furbrain/STIC/README.md

Shetland Attack Pony 6
======================

The Shetland Attack Pony 6 is a cave surveying tool. It is completely open source, all the code and hardware designs are available within this repository

Devices can be purchased from [my webshop](https://www.shetlandattackpony.co.uk)

Documentation is available at  [readthedocs](https://stic.readthedocs.io/en/latest/)
