furbrain/STIC/docs/Example of EU declaration of conformity (DoC) adopted by EMC ADCO.docx

EU Declaration of Conformity (DoC)

We

Company name: | Underwood Underground
Postal address: | 47 Robin Lane, High Bentham
Postcode: | LA2 7AG
City: | Lancaster
Telephone number: | +44 773 928 5952
E-Mail address:

declare that the DoC is issued under our sole responsibility and belongs to the following product:

Apparatus model/Product: | SAP6
Type:
Batch: | -
Serial number:

Object of the declaration (identification of apparatus allowing traceability; it may include a colour image of sufficient clarity where necessary for the identification of the apparatus):

See attached image. Colouration may vary

The object of the declaration described above is in conformity with the relevant Union harmonisation legislation:

EMC Directive 2014/30/EU

Directive 2011/65/EU — RoHS Directive, including (EU) 2015/863
Directive 2014/53/EU – Radio Equipment Directive | | | | ...

The following harmonised standards and technical specifications have been applied:

Title, Date of standard/specification:

IEC 62321-3-1: 2013 | | IEC 62321-5: 2013
Notified body (where applicable): | | 4 digit notified body number:
N/A

Additional information:

Signed for and on behalf of:

| | | | P. Underwood, Director
Place of issue | | Date of issue | | Name, function, signature
