furbrain/STIC/docs/RII exemption.odt

DECLARACIÓN DE EXENCIÓN – REGISTRO INTEGRADO INDUSTRIAL (RII)

Yo, Phil Underwood, actuando como fabricante del siguiente producto:

Producto: Shetland Attack Pony
Modelo / Tipo: SAP6

DECLARO QUE:

El fabricante no está establecido en España y no dispone de centro productivo ni establecimiento industrial en territorio español, por lo que no está obligado a inscribirse en el Registro Integrado Industrial (RII) de ninguna Comunidad Autónoma, de conformidad con la normativa aplicable.

Esta declaración se emite exclusivamente a efectos de su presentación ante la Aduana española.

En High Bentham, a 19/1/2026

Firma: P. Underwood
Nombre: Phil Underwood
Dirección: 47 Robin Lane, High Bentham, North Yorkshire, LA2 7AG
País: United Kingdom
