furbrain/STIC/docs/pony_art.png

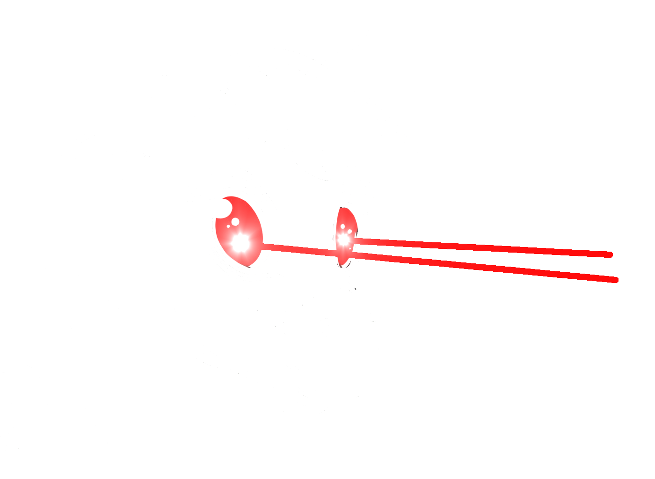
docs/pony_art.png
