furbrain/STIC/docs/SAP6b-228x228.jpg

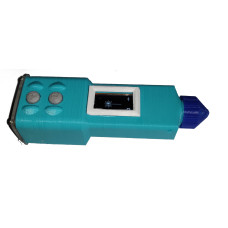
docs/SAP6b-228x228.jpg
