furbrain/STIC/docs/tshirt_front.png

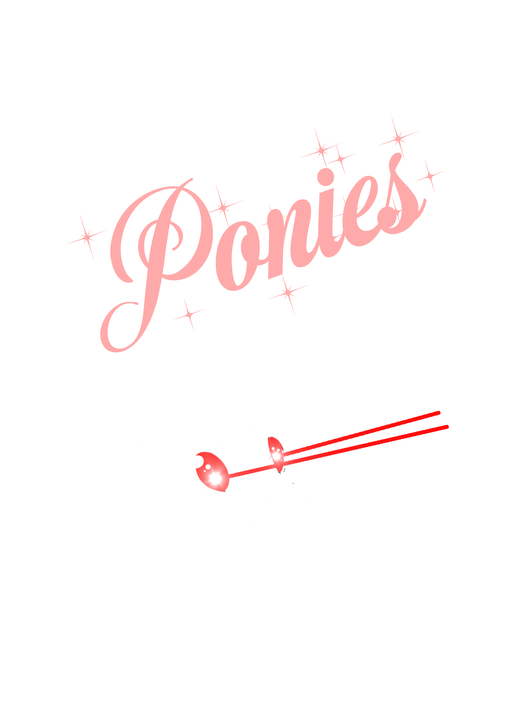
docs/tshirt_front.png
