furbrain/STIC/case/bigboy-mount.stl

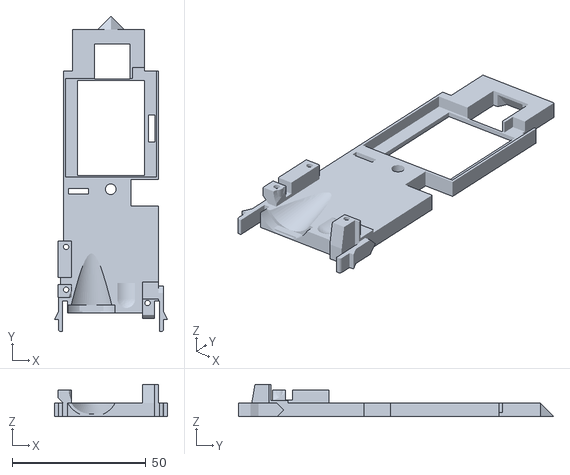
[picture p5: CAD file, 2025-06-13]
case/bigboy-mount.stl
42.3 x 118.0 x 12.0
