furbrain/STIC/hardware/Button/Button.step

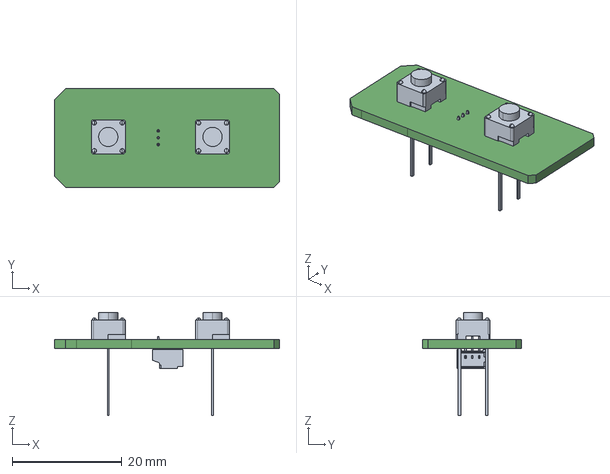
[picture p6: CAD file, 2023-05-13]
hardware/Button/Button.step
41.0 x 18.0 x 18.8 mm
