furbrain/STIC/hardware/PCB/STIC.step

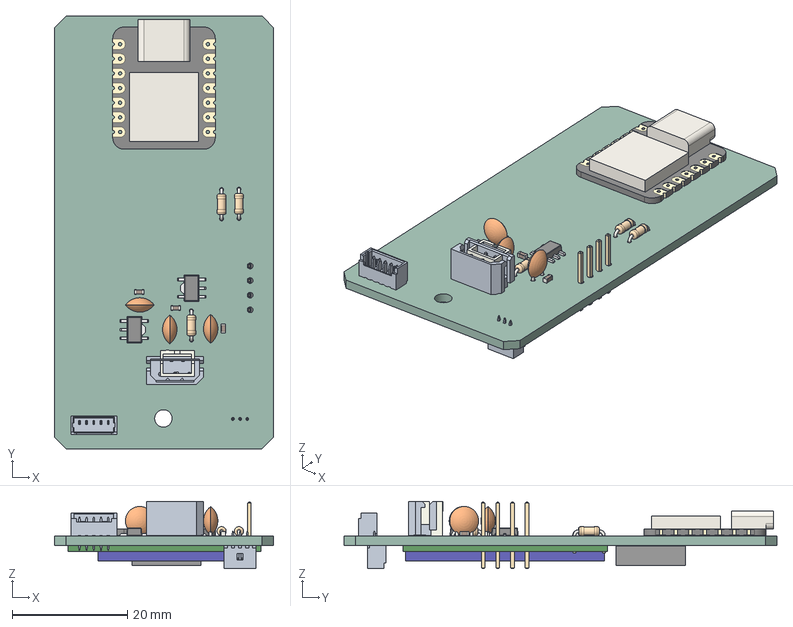
[picture p7: CAD file, 2024-05-04]
hardware/PCB/STIC.step
38.0 x 75.1 x 11.7 mm
Seeeduino Xiao v2
AP7361C-33Y5-13 x 2
C_Disc_D50mm_W25mm_P250mm x 3
R_Axial_DIN0204_L36mm_D16mm_P508mm_Horizontal x 3
JST_B2B_PH_K
C_0603_1608Metric x 3
R_0603_1608Metric x 3
ASSEMBLY
STIC_PCB
