furbrain/STIC/case/button_pcb_jig.stl

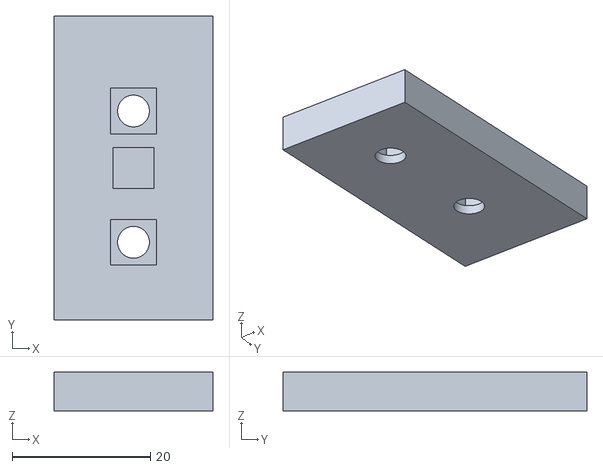
[picture p8: CAD file, 2024-11-16]
case/button_pcb_jig.stl
23.0 x 44.0 x 5.60
