furbrain/STIC/case/bigboy-Shim.stl

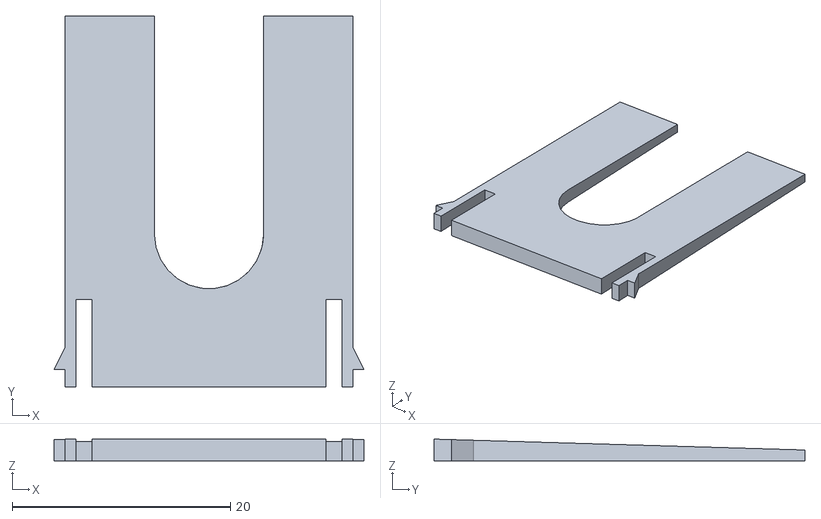
[picture p9: CAD file, 2023-12-16]
case/bigboy-Shim.stl
28.4 x 34.0 x 2.00
