furbrain/STIC/case/Acrylic.dxf

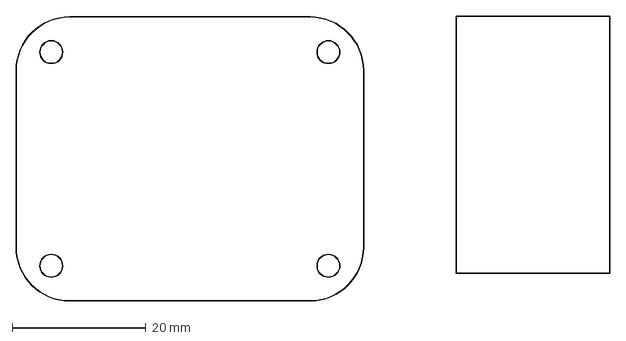
[picture p10: CAD file, 2023-12-16]
case/Acrylic.dxf
88.9 x 42.6 mm
