furbrain/STIC/case/button_mould.FCStd

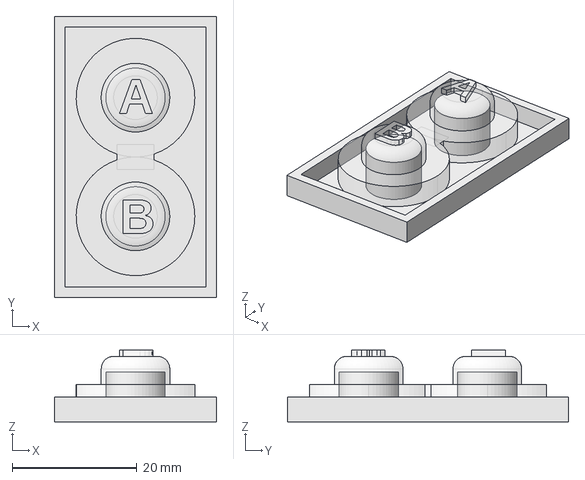
[picture p11: CAD file, 2023-08-31]
case/button_mould.FCStd
26.0 x 45.0 x 11.5 mm
TopPlain
Boot
