furbrain/STIC/case/bigboy-Shell.stl

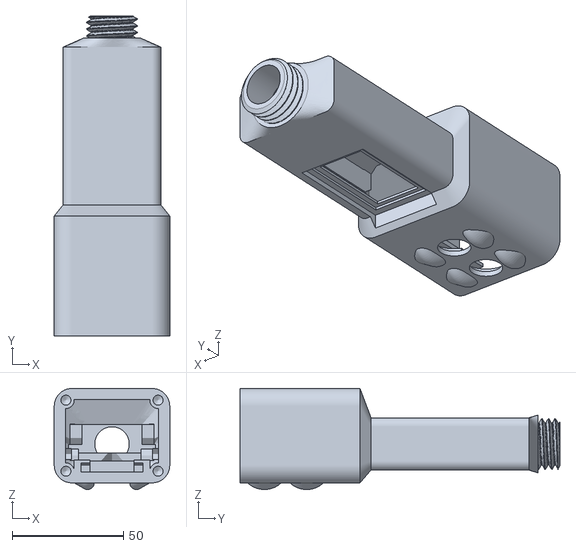
[picture p12: CAD file, 2023-06-18]
case/bigboy-Shell.stl
52.0 x 144.0 x 45.5
