furbrain/STIC/case/EVA Foam.dxf

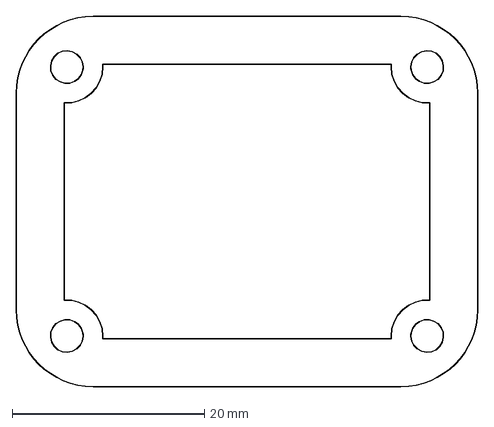
[picture p13: CAD file, 2023-03-01]
case/EVA Foam.dxf
48.0 x 38.5 mm
