furbrain/STIC/case/bigboy.FCStd

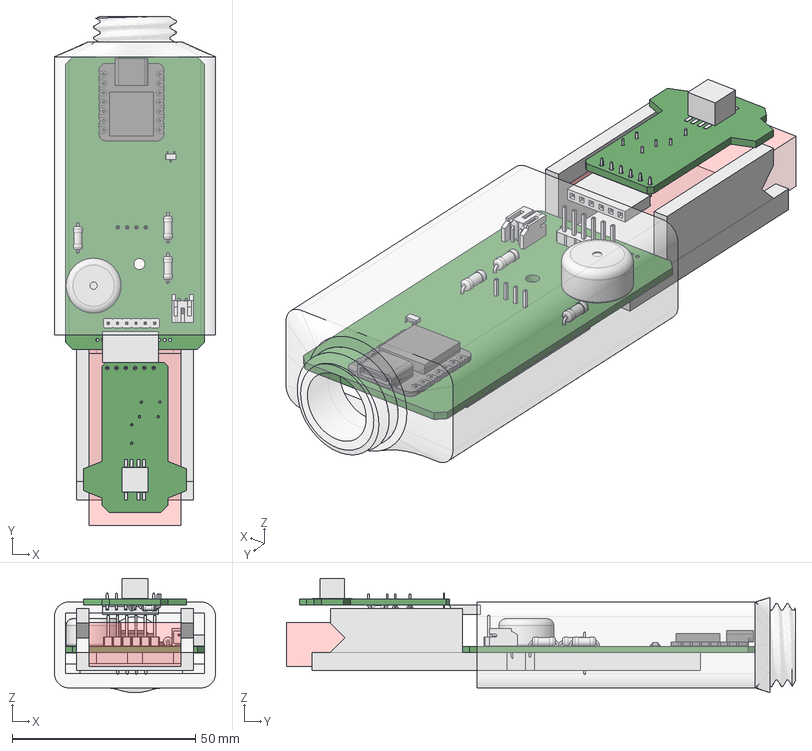
[picture p14: CAD file, 2023-01-22]
case/bigboy.FCStd
44.0 x 139.0 x 31.2 mm
Laser
mount
back
