furbrain/STIC/case/display_mount.FCStd

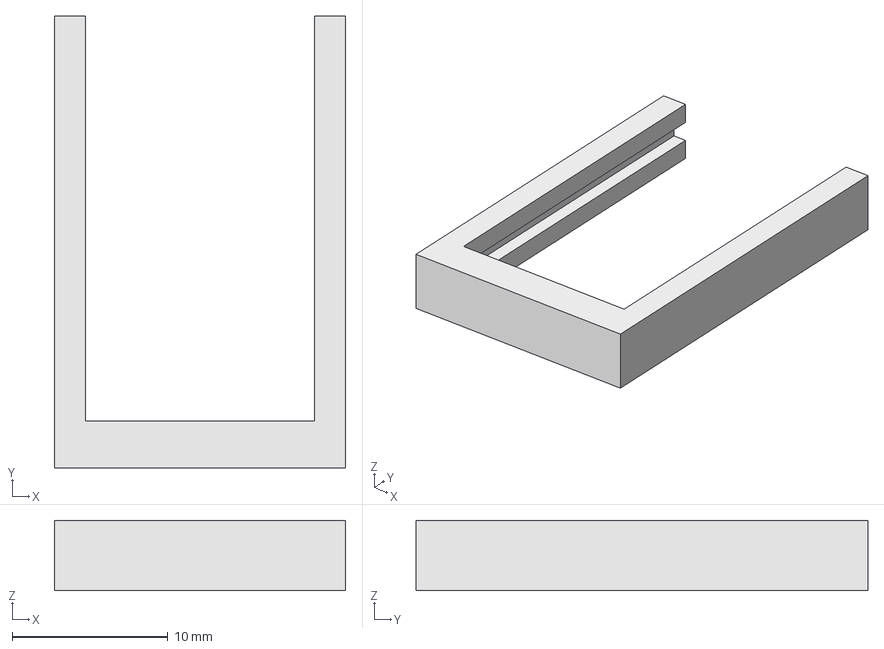
[picture p15: CAD file, 2023-01-22]
case/display_mount.FCStd
18.7 x 29.0 x 4.50 mm
