furbrain/STIC/(list of files, cad)

Other CAD files:
case/STIC.step
case/Button.step
case/display_mount.stl
