furbrain/STIC/(threads)

Thread 1 (2024-01-03):

certain laser read errors report as TimeoutError

echarlie, 2024-01-03:
sometimes when shooting at a reflective surface or at an odd angle surface, the screen displays `asyncio/funcs.py:75:wait_for TimeoutError:" rather than a Laser Read Error.

furbrain, 2024-01-04:
Looks like the code that picks up on the last errors doesn't account for this. I'll need to fix this

furbrain, 2024-01-06:
@echarlie  I'll make the timeout error give a nicer response.
Currently the timeout for the laser is set to 3s, would you prefer to wait longer and get a reading or get an error quicker?

Closed 2024-01-07.

Thread 7 (2024-01-08):

Document hard reset button

furbrain, 2024-01-08:
- [x] photo of end with arrow pointing at location
- [x] photo of bare board (again with arrow)
- [x] description on index.rst

furbrain, 2024-04-20:
Done

Closed 2024-04-20.

Thread 8 (2024-01-08):

Document production process

furbrain, 2024-01-08:
- [ ] Make BOM
- [ ] link to files on github releases
- [ ] update docs

milewis, 2024-09-03:
Phil,

I'm working on building a SAP from scratch.  I've got the board soldered up and have the device showing as circuitpy on my computer.  I'm a bit lost as to which files I should be moving over to the nrf device.  Any direction would be very helpful.  I'd also love to help with any documentation I can.  Are you needing anything on the build process documented in particular?

furbrain, 2024-09-07:
The first thing is you need a special version of circuitpython installed - you can get it from https://github.com/furbrain/SAP6_board/releases/download/1.0/sap6_cp_9.0.0.uf2
You will need to create a `firmware` directory on the nrf device and put all the python files from `firmware.zip` in there.

You will also need to create and populate the `fonts` and `images` directories, and also copy `safemode.py` `boot.py` and `code.py` from `firmware/installer` into the root directory. The final directory structure should look like:
```
├── boot.py
├── code.py
├── firmware
│   ├── ***lots of python files***
│   └── versions
│       ├── display128x64.py
│       ├── hardware_v1.py
│       └── __init__.py
├── fonts
│   ├── limited
│   ├── terminus_20_ascii.pcf
│   ├── terminus_22_ascii.pcf
│   ├── terminus_24_ascii.pcf
│   └── terminus_28_ascii.pcf
├── images
│   ├── battery.bmp
│   ├── batt_icon.bmp
│   ├── bt.bmp
│   ├── laser.bmp
│   └── laser.xbm
├── manual.pdf
└── safemode.py
```

Thread 13 (2024-01-15):

Device becomes unresponsive several months after first power on

furbrain, 2024-01-15:
1-2 months after power on the device stops responding to the button presses to turn on

furbrain, 2024-01-15:
This is due to circuitpython's `time.monotonic()` returning a float, which only has 22 bits of precision. As it represents time since power first applied to device (which is not reset by a reset!), this will start degrading to 1 second resolution after about 25 days. This means that the turn on code may stop working at this point (possibly 50 days), difficult to test.

Fix is to switch to `supervisor.time_ms()`, which is an int. This can wrap but would need an attempt to switch on at *exactly* the right moment. A second attempt would then be successful

Closed 2024-01-15.

Thread 20 (2024-02-06):

consider power-off with double-click B instead of A

echarlie, 2024-02-06:
On a survey trip with the SAP6 over the weekend, I found we would shut down the SAP on accident fairly often, either by muscle spasm while taking a shot, or it not responding immediately when turning on (so you get a trill of the power on, then the power off sound, before the screen has powered up).

Changing power-off to the B button would ensure this happens accidentally less often.

furbrain, 2024-02-07:
Unfortunately double-click B is now taken as "return to most recent reading", when browsing through previous readings.
There is a lockout to prevent turn-on- turn-off, but it's only 0.5s. I'd be open to a PR to change this to say 2-5 seconds (it's in quitter_task in app.py)

Phil

echarlie, 2024-02-12:
"return to most recent reading" sounds better. I was sketching out a bit of code to allow going back and forth through old readings, but I think that is 1) more memory-intensive, and 2) creates a very weird behaviour for exiting to the measure mode. (see https://github.com/furbrain/STIC/commit/26f3e01bdbf80b00d19f56799c10245ebc8a9d1a if you're curious).

Thread 21 (2024-02-28):

Consider shortening tailcap by 5mm for better case fitment

echarlie, 2024-02-28:
The SAP6/STIC is approximately 5mm too long to fit nicely in a Peli 1030 micro case. As there aren't many options for cases *slightly* larger, and most people like to keep instruments in a case for transport (and to protect them from mud between stations), slightly modifying the dimensions for optimal fit in the Peli 1030 would be desirable.

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

as you can see from the photos, it is a loose fit with the tailcap off, but a very close fit with the tailcap on (the case does in fact close, but the device is jammed in very tightly, with the tailcap wedged against the top foam). Shortening the tailcap (or the rest of the device) by 5-8mm would result in a very good fit.

furbrain, 2024-03-31:
Thanks for the input. Next hardware version will be a bit shorter!

furbrain, 2024-04-24:
The case in branch 6.2 now fits. Needs to be used with PCB from this branch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

furbrain, 2024-05-18:
Fixed in hardware version 6.2

Closed 2024-05-18.

Thread 23 (2024-04-02):

Error on startup if device has previously been shutdown without taking a reading

furbrain, 2024-04-02:
This bug was introduced in 1.3.0

Closed 2024-04-16.

Thread 24 (2024-04-16):

Calibration does not work with old circuitpython versions

furbrain, 2024-04-16:
Old (pre 9.0.0) versions of `circuitpython` ship with a version of `ulab` that does not have `A.T` where A is a numpy array. Instead, only `.transpose()` is available

Version 1.3.0 introduces a bug where calibration attempts to use the `A.T` form

furbrain, 2024-04-16:
Fixed by https://github.com/furbrain/STIC/commit/683c2db89ee0fa0bd9eb909b1a77d9fe39fa4326

furbrain, 2024-04-16:
Fixed by https://github.com/furbrain/STIC/commit/683c2db89ee0fa0bd9eb909b1a77d9fe39fa4326

Closed 2024-04-16.

Thread 25 (2024-05-13):

Unclear PCB instructions

mlubej, 2024-05-13:
Hi!

Thank you for this really nice project, I love the fact that you took the time to make it so open-source and enable us to build our own.

I will try to go through the process of creating my own device, but have limited experience with hardware.

I just ordered the manufacturing of the PCBs on pcbway.com and I have received a few question from their side regarding the files, such as:

First question:

> Pls check the attached pic,the pointed pad of the top copper layer is covered with soldermask ink.So do you need us to add soldermask opening for the pointed pad to make it exposed?

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

Second question is very similar:

> Pls check the attached pic,the two circled pads are also both covered with soldermask ink.So do you need to add soldermask openings for the two pads to make them exposed？

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

Am I correct in assuming that the marked parts should have an opening in the solder mask ink?

Thank you!

PS: I might ask a bit more often about the manufacturing process and try to document any issues so that we can improve the docs/manual.

milewis, 2024-05-13:
None of those pads are used in the design, so they have been covered up by solder mask in the most recent version of the board.  The only pad that is under the chip PCB is the BATT pad, which has a hole through to the back side so that it can be easily soldered with a torch.

furbrain, 2024-05-13:
Exactly as milewis has said - these are deliberate design decisions.

Phil

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

furbrain, 2024-05-13:
Matic, thank you for your help with this please do identify any issues that
you come across!

Phil

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

mlubej, 2024-05-17:
Thank you for the info!

mlubej, 2024-05-17:
BTW, due to my lack of knowledge I ordered them to create openings in the solder mask ink before asking you here. Do you think this is a problem? I guess I can cover the parts myself?

furbrain, 2024-05-17:
I think it is unlikely to be a problem. Previous versions if the board did
not have the solder mask and it was fine.

Phil

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

mlubej, 2024-05-17:
Thanks for the quick reply! Looking forward to mowing forward with this.

Closed 2024-05-17.

Thread 26 (2024-05-17):

Ordering components

mlubej, 2024-05-17:
Hi @furbrain!

I wanted to order the electrical components, but realized that the purchase might need to be quite dispersed across various sites, especially for the more complex components, such as the magnetometer, BLE, laser module, etc... I have a few questions:

- do you order the laser module directly from Egismos?
- where do you prefer to order the items from the `bom.csv` which don't have the Farnell part number?
- in the BOM there are 6 resistors in groups of 3 which seem to be different, but point to the same Farnell part number (9342788). Is this a mistake?
- how do you manage to sell the SAP6 at such a small price compared to the sum of costs I need to pay for the components alone? 😂

Thank you!

furbrain, 2024-05-18:
- Yes I order the laser modules directly from egismos. There was a time when they were available from Amazon, but no longer
- The items which are not available via farnell I tend to get from aliexpress - there are urls in bom.csv. You don't need U4
- The 6 resistors with the same part number is an error. There are two lots of resistors and capacitors, depends on whether you want to use through hole or surface mount. So you either need R1,R2,R3 (SMT) *or* R_1, R_2, R_3. Any 2k resistor in 0603 package is suitable for SMT. The same applies for C1, C_1 etc
- I get stuff cheap when I gets lots of them (especially with the laser module - cost of shipping per unit is much better hen buying in bulk)!

mlubej, 2024-06-17:
Hi!

Thank you for your reply, it was helpful. I managed to order the Laser and some of the other components. I might drop in with some question every now and then and I'll use this ticket here.

- I think I spotted an error with the manufacturer number for `C1` and `C2` components. The stated number is the same as for the `C3` capacitor, but this can't be, since the capacitance is different. Perhaps [this one](https://www.aliexpress.com/item/1005006523977750.html?spm=a2g0o.cart.0.0.584338da33Svnz&mp=1) should be stated?
- I'm having trouble understanding the `U4` component. It seems to be linked to the RM3100 breakout board (`U2` component), but it's not exactly clear what this component is, nor can I find it due to missing part numbers. can you please help me out here?
- for the `J4` component I see that the 100mm long cable is used. do you think the 150 mm cable would fit as well?

furbrain, 2024-06-17:
Yes, there is an error in my parts list - I will update shortly. The part you have identified is appropriate, my device uses https://jlcpcb.com/partdetail/16531-CL10A105KB8NNNC/C15849. However, the 4.7uF capacitors would probably work perfectly well.

The J4 jumper cable - 100mm works very nicely, you would likely get away with the 150mm but might need to tuck it out of the way of the laser once assembled.

U4 was sort of an experiment - there is a different breakout board for the RM3100, which it looked like I might need to use; I was going to try to fit both options on the board but it didn't work out.

Do let me know if any more questions!

mlubej, 2024-10-05:
Hi @furbrain!

Progressing well with building the SAP! I have a few more questions, mostly about the battery

- turns out the battery I received has 2 wires instead of the 3  like in case of the one in the `bom.csv`. Do you think that's a problem?
- in the `bom.csv` there is the `J5` component (the JST 2 way header) as well as the `J1` component (molex 3 way pin header), which both seem to be going to the same place on the PCB. Does that mean that you made a design so both kinds of batteries can be used, or am I doing something wrong?
- for the laser, I have received a 5-way cable which connects to the laser module, but has wires on the other side, so I'm missing a 5 way single row female pin header which I can plug in the board. Was this also in your case? Is the component missing from the `bom.csv`?

furbrain, 2024-10-05:
Hi @mlubej

- Two wires on the battery is no problem, but you will need to use the J5 component, not the J1. Make certain you get the polarity correct
- Yes the design was meant so you could use either type of battery
- I think there is an error in the bom - you will need a 5 way picoblade cable with female headers on both ends - you will need part number 15134-0500

Thread 27 (2024-07-12):

Battery question - is it non-magnetic?

mlubej, 2024-07-12:
Hi @furbrain!

One question regarding the battery. The Disto-X2 used for caving uses the non-magnetic [LiPo battery (PGEB-NM053040)](https://www.powerstream.com/non-magnetic-lipo.htm), but the [battery used in SAP6](https://cpc.farnell.com/unbranded/lp-523450-is-3/battery-lithium-pol-3-7v-950-mah/dp/BT06802) doesn't seem to have any specific information regarding the battery. Do you have any information if the current battery is non-magnetic, or if the draining currents of the battery may affect the magnetometer and therefore the measurements?

Comparing the batteries, it seems that both are 3.7 V and 5 mm thickness, and the non-magnetic one is even smaller in width x height. Does this mean that the battery could be changed basically in place?

Thank you!

furbrain, 2024-07-12:
I've tested various lipo batteries with the magnetometer, and none of them
have any significant ferromagnetism to the extent that it affects the
readings.

Any electrical current will of course generate a magnetic field which is
why I have tried to keep the battery away from the magnetometer.

The battery can be exchanged for a different one with no problems, so long
as it is at least 500mAh. Smaller batteries will have problems because the
charging current would be too high

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

mlubej, 2024-07-15:
Thank you so much for this information!

Closed 2024-07-15.

Thread 28 (2024-07-12):

SAP6 feedback - physical attributes

mlubej, 2024-07-12:
Hi @furbrain!

At our local caving club we have received the SAP6 and have already field-tested it. There were some changes in measurements compared to the Disto-X2, but the Disto-X2 was not calibrated, so we have to repeat this test. Otherwise the calibration process of the SAP6 is really simple and the device is intuitive enough. We may change the interface and button usage a bit to fit more to our needs. If there are any generic updates or bugfixes, we will prepare a PR.

There were a few weird crashes which we cannot reproduce yet, but we'll try it out more. We even have all the electrical components now to try to make our own (except for the battery, because we'd like your input from #27 first)

One comment from our side is that the 3D prints seem a bit bad, and for a purchased item such as this we would have expected better quality prints. Perhaps your 3D printer is not calibrated well.

The print seems to be warped at the base and at the screen part

|||
|-|-|
|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|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|

and the cap has some holes in the layers, which is a sign of under-extrusion

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

Additional comment regarding the glass layer: is there a way that we could protect this? did you have any ideas in the past already? If you agree that it would be a good idea, I can design a TPU "cap" with a hole which would fit on the glass part. Accepting also other ideas

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

Will continue testing and giving feedback, thanks!

mlubej, 2024-07-12:
BTW, I see that you used ABS for this, which is famous for warp issues on the print bed. IMO ABS is best for situations where high-temperature resistance is needed, but if that is not a requirement, PET-G is equally good, since it's still very robust and much easier to print. Do you think it would be a suitable replacement to ABS in this product?

furbrain, 2024-07-12:
Unfortunately the reel of filament for your device did have some warping. I
have now moved to a commercial 3d printer and have not had any further
issues with it

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

furbrain, 2024-07-12:
About the glass part: this is laser cut acrylic, so it's fairly robust. It
would also be easy to replace if it became damaged. Currently the device
fits precisely in a peli case, so I don't want to make it any bigger for
the general user. I think having an optional tpu protector could be a good
idea however, maybe I could have this as an accessory. Also spare front
pieces cloud be an idea

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

furbrain, 2024-07-12:
Other people have used some clear adhesive tape on the front of the device
to use as sacrificial protection which can then be really replaced

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
>>> BTW, I see that you used ABS for the prints, which is famous for warp
>>> issues on the print bed. IMO ABS is best for situations where
>>> high-temperature resistance is needed, but if that is not a requirement,
>>> PET-G is equally good, since it's still very robust and much easier to
>>> print. Do you think it would be a suitable replacement to ABS in this
>>> product?
>>>
>>> —
>>> Reply to this email directly, view it on GitHub
>>> <https://github.com/furbrain/STIC/issues/28#issuecomment-2225175818>,
>>> or unsubscribe
>>> <https://github.com/notifications/unsubscribe-auth/AAW3PXLWGK256SOPVUV3D7TZL6N4XAVCNFSM6AAAAABKYP2BDGVHI2DSMVQWIX3LMV43OSLTON2WKQ3PNVWWK3TUHMZDEMRVGE3TKOBRHA>
>>> .
>>> You are receiving this because you were mentioned.Message ID:
>>> ***@***.***>
>>>
>>

Thread 31 (2024-11-08):

Alternate laser module - TW10S-UART

milewis, 2024-11-08:
I'm looking at using an alternate laser module that is available very inexpensive on Aliexpress for $30.  The TW10S-UART  uses UART and will connect to the same 5-pin port that the Egismos connects to on the SAP board, but uses different pin locations (I have just moved the wires in the wiring harness for testing.  I am currently working on a port of the laser_Egismos library to change the packet data from the commands for the Egismos to the commands for the TW10S-UART.  The downside I have seen so far is that the distance is lower, but  for the caves I am currently surveying, this is not an issue as my shots are rarely over 50' (15m).  I have added the documentation from the site where I purchased the laser module that goes over the UART commands.
[TW10S-UART Documentation.docx](https://github.com/user-attachments/files/17683242/TW10S-UART.Documentation.docx)

furbrain, 2024-11-08:
That looks very interesting! I like that it has a proper connector on it
(other laser modules need to have wires soldered directly on to the board).
My experience is that the maximum range is only achievable in perfect
conditions - no mist, matt white target etc. I've found in caves with dark
shiny rock you often get a much shorter maximum range. With the sap5, using
a cheaper 30m laser I was getting many people reporting poor performance.

It should be reasonably easy to generate a new hardware version.

I'll put an update to the docs with me details on how to implement a new
hardware version

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

furbrain, 2024-11-08:
Of course the best thing to do is test the lasers in real life
conditions....

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

furbrain, 2024-11-10:
I've put some more information about making ponies with different hardware [on readthedocs](https://stic.readthedocs.io/en/latest/#make-a-derivative)

Thread 34 (2024-12-10):

Threaded sockets

MaticDiba, 2024-12-10:
Hi,
I’m having difficulty finding information about the "threaded sockets" used for securing the front cover. Could you provide more details?

Thank you

furbrain, 2024-12-10:
Hi these are M3 brass inserts, 5mm long. Here's what I use:
https://uk.rs-online.com/web/p/threaded-inserts/0278534

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
