furbrain/STIC/hardware/PCB/STIC.kicad_pcb

## KiCad design hardware/PCB/STIC.kicad_pcb (2024-01-19)

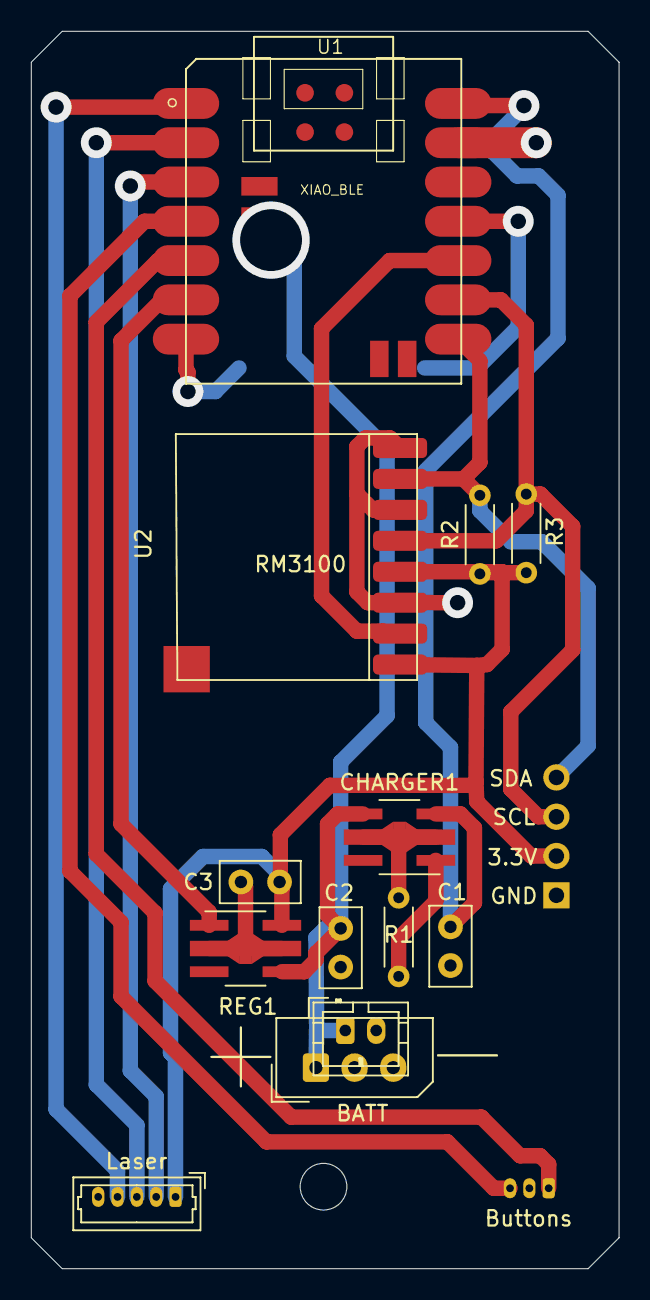
[picture p17: board STIC.kicad_pcb from above]

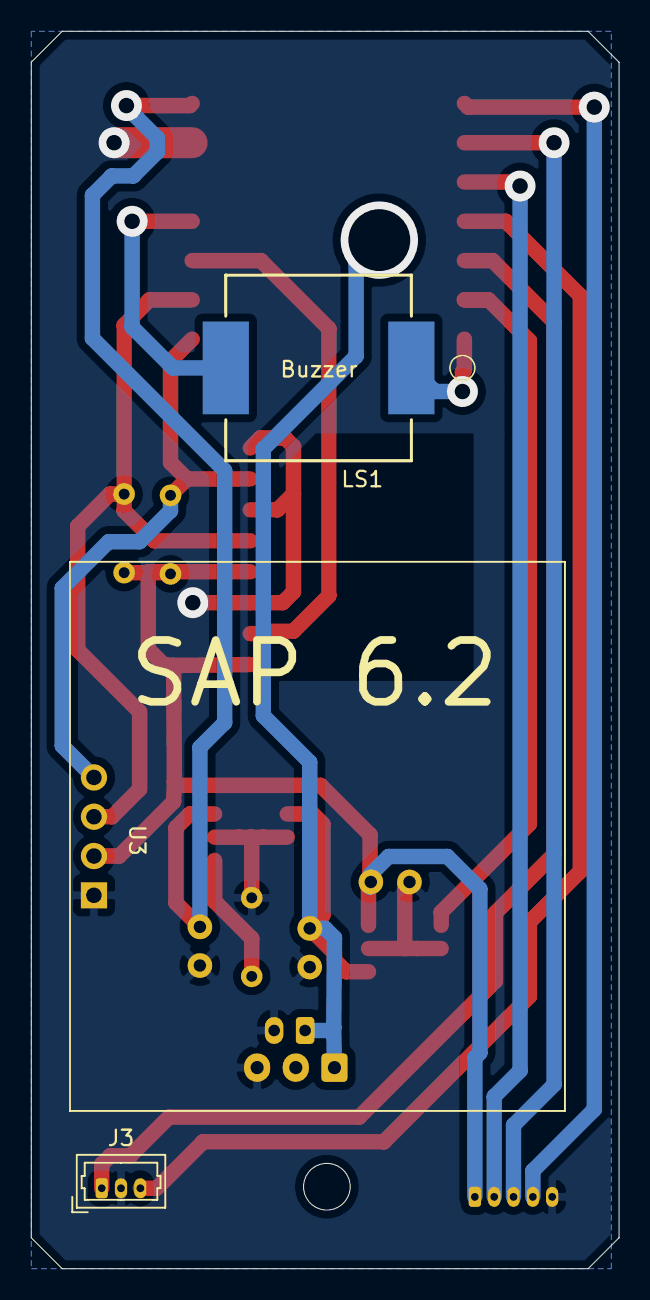
[picture p18: board STIC.kicad_pcb from below]

Board: 2 copper layers, 38.0 x 80.0 mm, 16 parts (3 on the bottom side), 16 nets.

Parts:
C1, C2: 1.0uF; C_Disc_D5.0mm_W2.5mm_P2.50mm
C3: 4.7uF; C_Disc_D5.0mm_W2.5mm_P2.50mm
CHARGER1: XC6802A42XMR-G; SOT-89-5_Handsoldering
J1: 22-03-5035; Molex_SPOX_5267-03A_1x03_P2.50mm_Vertical
J2: 53047-0510; Molex_PicoBlade_53047-0510_1x05_P1.25mm_Vertical
J3: 53047-0310; Molex_PicoBlade_53047-0310_1x03_P1.25mm_Vertical
J5: Conn_01x02; JST_PH_B2B-PH-K_1x02_P2.00mm_Vertical
LS1: Speaker; SPKR_AST1240MLTRQ
R1, R2, R3: 2k; R_Axial_DIN0204_L3.6mm_D1.6mm_P5.08mm_Horizontal
REG1: AP7361C-33Y5-13; SOT-89-5_Handsoldering
U1: XIAO_BLE; Seeeduino_XIAO-MOUDLE14P-2.54-21X17.8MM
U2: RM3100_Breakout
U3: OLED1_3_GND1; OLED1_3

Connections:
+3V3: C3.1, J2.1, R2.1, R3.1, REG1.5, U2.1, U2.4, U3.2
+BATT: C2.1, CHARGER1.4, J1.1, J5.1, REG1.4, U1.15
/BUTTON_A: J3.3, U1.4
/BUTTON_B: J3.1, U1.5
/BUZZER_A: LS1.2, U1.11
/BUZZER_B: LS1.1, U1.7
/DRDY: U1.10, U2.2
/LASER_EN: J2.4, U1.1
/PERIPH_EN: REG1.1, U1.6
/Rx: J2.3, U1.2
/SCL: R3.2, U1.9, U2.5, U3.3
/SDA: R2.2, U1.8, U2.7, U3.4
/Tx: J2.2, U1.3
GND: C1.2, C2.2, C3.2, CHARGER1.2, J1.3, J2.5, J3.2, J5.2, R1.2, REG1.2, U1.13, U2.3, U2.6, U2.8, U3.1
unnamed: CHARGER1.1, R1.1
VBUS: C1.1, CHARGER1.3, U1.14
