furbrain/STIC/firmware/measure.py

import asyncio
import json

from async_button import Button
from laser_egismos import LaserError
# noinspection PyProtectedMember
from mag_cal import MagneticAnomalyError, DipAnomalyError, GravityAnomalyError, NotCalibrated

try:
    # noinspection PyUnresolvedReferences
    from typing import Dict
except ImportError:
    pass

from . import config
from . import display
from . import hardware
from .data import readings, Leg
from .debug import logger
from .utils import check_mem

LASER_TIMEOUT = 4.5

ERROR_MESSAGES: Dict[type, str] = {
    LaserError: "Laser\nRead\nFailed",
    asyncio.TimeoutError: "Laser\nRead\nTimeout",
    MagneticAnomalyError: "Magnetic\nAnomaly:\nIron nearby?",
    DipAnomalyError: "Magnetic\nAnomaly:\nIron nearby?",
    NotCalibrated: "Calibration\nneeded\nHold B 3s",
    GravityAnomalyError: "Device\nMovement\nDetected",
}


async def measure(devices: hardware.HardwareBase, cfg: config.Config, disp: display.DisplayBase):
    """
    This is the main measurement task
    :return:
    """
    # need to switch display to measurement here...
    logger.debug("Showing start screen")
    check_mem("start screen")
    disp.show_start_screen()
    check_mem("startup shown")
    logger.debug("turning on laser")
    devices.laser_enable(True)
    await asyncio.sleep(0.1)
    logger.debug("turning on laser light")
    showing_extents = False
    while True:
        try:
            await devices.laser_on(True)
        except LaserError:
            # possibly received a timeout last time around
            pass
        if devices.button_b.last_click == Button.DOUBLE:
            # we often miss the double B click due to the time taken to update the screen
            # check if this has happened, and then reset it
            btn = "b"
            click = Button.DOUBLE
            devices.button_b.last_click = Button.SINGLE
        else:
            btn, click = await devices.both_buttons.wait(a=(Button.SINGLE, Button.LONG),
                                                         b=(Button.SINGLE, Button.DOUBLE))
        check_mem("button pressed")
        if btn == "a":
            if click == Button.SINGLE:
                await asyncio.sleep(0.3)
            # long click should start timer.
            if click == Button.LONG:
                for i in range(cfg.timer):
                    devices.beep_bip()
                    await asyncio.sleep(1)
            success = await take_reading(devices, cfg, disp)
            showing_extents = False
        elif btn == "b":
            if click == Button.SINGLE:
                logger.debug("B pressed")
                if cfg.extended and readings.is_first_reading() and not showing_extents:
                    showing_extents = True
                else:
                    readings.get_prev_reading()
                    showing_extents = False
                success = True
            elif click == Button.DOUBLE:
                logger.debug("B double pressed")
                readings.get_first_reading()
                showing_extents = False
                success = True
        # noinspection PyUnboundLocalVariable
        if readings.current_reading is not None and success:
            disp.update_measurement(readings.current, readings.current_reading, showing_extents)


async def get_raw_measurement(devices: hardware.HardwareBase, disp: display.DisplayBase, with_laser: bool = True):
    logger.info("Taking a reading")
    try:
        disp.sleep()
        if with_laser:
            distance = await asyncio.wait_for(devices.laser_measure(), LASER_TIMEOUT) / 1000
        else:
            distance = None
        logger.debug(f"Raw Distance: {distance}m")
        await devices.laser_on(False)
        await asyncio.sleep(0.1)
        mag = devices.magnetometer.magnetic
        logger.debug(f"Mag: {mag}")
        grav = devices.accelerometer.acceleration
        logger.debug(f"Grav: {grav}")
        await devices.laser_on(True)
    finally:
        disp.sleep(wake=True)
    return mag, grav, distance


async def take_reading(devices: hardware.HardwareBase,
                       cfg: config.Config,
                       disp: display.DisplayBase) -> bool:
    # take a reading
    try:
        try:
            mag, grav, distance = await get_raw_measurement(devices, disp, True)
            if cfg.calib is None:
                raise NotCalibrated()
            # noinspection PyTypeChecker
            azimuth, inclination, _ = cfg.calib.get_angles(mag, grav)
            distance += cfg.laser_cal
            logger.debug(f"Distance: {distance}m")
            if cfg.anomaly_strictness is not None:
                # noinspection PyTypeChecker
                cfg.calib.raise_if_anomaly(mag, grav, cfg.anomaly_strictness)
        except tuple(ERROR_MESSAGES.keys()) as exc:
            isMagneticError = False
            for key in ERROR_MESSAGES.keys():
                if isinstance(exc, key):
                    # spic17: for error messages happening often during measurement display bitmaps instead of text
                    # because this saves a lot of memory and thus significantly reduces
                    # the number of out of memory exceptions
                    if (key == MagneticAnomalyError) or (key == DipAnomalyError):
                        disp.show_bitmap_info('error_magnetic')
                        isMagneticError = True
                    elif (key == GravityAnomalyError):
                        disp.show_bitmap_info('error_movement')
                    elif (key == LaserError):
                        disp.show_bitmap_info('error_laser')
                    else:
                        # all other error messages                
                        disp.show_big_info(ERROR_MESSAGES[key])
            logger.info(f"Measurement error: {repr(exc)}")
            if not isinstance(exc, asyncio.TimeoutError):
                # don't wibble the laser if it's timed out, it'll just get more confused
                devices.flash_laser(5,0.1)
            if isMagneticError:
                # spic17: send acoustic signal for magnetic error (this is relevant for the surveyor).
                devices.beep_sad_magnetic()
            else:
                devices.beep_sad()
            await asyncio.sleep(0)
            return False
        else:
            leg = Leg(azimuth, inclination, distance)
            readings.store_reading(leg, cfg)
            devices.bt.disto.send_data(azimuth, inclination, distance)
            if readings.triple_shot():
                devices.flash_laser(2,0.2)
                devices.beep_happy()
            else:
                devices.beep_bip()
            await asyncio.sleep(0)
            return True
    except MemoryError:
        # spic17: better not do anything not strictly neccessary in these delicate moments after a memory error   
        # TODO: do something more drastic here after maybe 3 occurences  (reboot?)
        #       because the device may not be able to recover otherwise?
        return False
    
async def take_multiple_readings(devices, disp, fname, prelude, reminder):
    devices.laser_enable(True)
    disp.show_info(prelude)
    await devices.button_a.wait(Button.SINGLE)
    await devices.laser_on(True)
    mags = []
    gravs = []
    count = 0
    while True:
        disp.show_info(f"Legs: {count}\r\n{reminder}")
        button, click = await devices.both_buttons.wait(a=(Button.SINGLE, Button.LONG), b=Button.SINGLE)
        if button == "a":
            if click == Button.SINGLE:
                await asyncio.sleep(0.5)
            mag, grav, _ = await get_raw_measurement(devices, disp, False)
            mags.append(mag)
            gravs.append(grav)
            devices.beep_bip()
        elif button == "b":
            devices.beep_bop()
            break
        count += 1
    try:
        # save data if we can
        with open(fname, "w") as f:
            json.dump({"mag": mags, "grav": gravs}, f)
    except OSError:
        pass
    return mags, gravs


# noinspection PyUnusedLocal
async def save_multiple_shots(devices: hardware.HardwareBase, cfg: config.Config, disp: display.DisplayBase):
    prelude = "Press A\r\nto start recording\r\nPress B to stop"
    reminder = "Press B to stop"
    fname = "debug_shots.json"
    await take_multiple_readings(devices, disp, fname, prelude, reminder)
