furbrain/STIC/firmware/data.py

import os
import re
from collections import namedtuple
import atexit
try:
    # noinspection PyUnresolvedReferences
    from typing import Optional, TextIO
except ImportError:
    pass


from .config import Config
import mag_cal
from mag_cal.utils import np
from .discarding_queue import DiscardingQueue

Leg = namedtuple("Leg", ("azimuth", "inclination", "distance"))

READINGS_DIR = "/readings/"


class Readings:
    """
    This class represents the set of most recent readings, whether a reading has been
    taken recently, and what is the current viewed reading
    """

    def __init__(self, max_len=10):
        self._queue = DiscardingQueue([], max_len)
        self.current_reading = None
        """None if no readings taken yet, otherwise last reading is -1, previous to that is -2 
        etc"""
        try:
            os.mkdir(READINGS_DIR)
        except OSError:
            pass
        self._trip_file: Optional[TextIO] = None

    def store_reading(self, leg: Leg, cfg: Config):
        self._queue.append(leg)
        self.current_reading = -1
        if cfg.save_readings and self.trip_file:
            texts = (
                cfg.get_distance_text(leg.distance, decimals=3, with_unit=False),
                cfg.get_azimuth_text(leg.azimuth, decimals=1, with_unit=False),
                cfg.get_inclination_text(leg.inclination, decimals=1, with_unit=False),
            )
            self.trip_file.write(f"{', '.join(texts)}\n")

    def is_first_reading(self):
        return self.current_reading == -1

    def get_first_reading(self):
        if len(self._queue) > 0:
            self.current_reading = -1

    def get_prev_reading(self):
        if self.current_reading is None:
            self.get_first_reading()
        else:
            self.current_reading -= 1
            if self.current_reading < -len(self._queue):
                self.current_reading = -1

    @property
    def current(self) -> Leg:
        return self._queue[self.current_reading]

    @property
    def trip_file(self):
        if self._trip_file:
            return self._trip_file
        try:
            max_trip = 0
            for fname in os.listdir(READINGS_DIR):
                match = re.match(r"Trip(\d\d\d\d\d).csv", fname)
                if match:
                    max_trip = max(max_trip, int(match.group(1)))
            f: TextIO = open(f"{READINGS_DIR}Trip{(max_trip + 1):05}.csv", "w")
            f.write("Distance, Compass, Clino\n")
            atexit.register(f.close)
            self._trip_file = f
            return f
        except OSError:
            return None

    def flush(self):
        # not using the property because we don't want to create a file if not already existing here...
        if self._trip_file:
            self._trip_file.flush()

    # noinspection PyTypeChecker
    @staticmethod
    def _same_shots(a: Leg, b: Leg) -> bool:
        """
        Determines if two shots were to the same point.
        :param Leg a: First leg to compare
        :param Leg b: Second leg to compare
        :return: True if <5cm distance change and less than 3% error in measurement
        """
        if abs(a.distance-b.distance) > 0.05:
            return False
        vec_a = mag_cal.Calibration.angles_to_matrix(a.azimuth, a.inclination, 0)[:, 1]
        vec_b = mag_cal.Calibration.angles_to_matrix(b.azimuth, b.inclination, 0)[:, 1]
        angular_variation = np.linalg.norm(vec_a-vec_b)
        return angular_variation < 0.03

    def triple_shot(self) -> bool:
        """
        Determines if last three shots taken were all to the same point.
        :return: True if <5cm distance change and less than 3% error in measurement
        """
        if len(self._queue) < 3:
            return False
        # spic17: we need to compare all three pairs of measurements instead of just 1+2 and 2+3 here
        # in order to ensure that first and third shots are near enough each other, too
        # (otherwise the sap would recognize legs that sexytopo does not).
        return self._same_shots(self._queue[-1], self._queue[-2]) and self._same_shots(self._queue[-2], self._queue[-3]) and self._same_shots(self._queue[-1], self._queue[-3])


readings = Readings()
