furbrain/STIC/firmware/tests/test_current.py

# noinspection PyPackageRequirements
import alarm
import _bleio
import board
import time
import asyncio

import version


async def runner():
    with version.get_device():
        await asyncio.sleep(0.3)


LIGHT_SLEEP_TIMEOUT = 60
_bleio.adapter.stop_advertising()
time.sleep(0.1)
asyncio.run(runner())
pins = version.get_pins()
pin_alarm = alarm.pin.PinAlarm(pins.BUTTON_A, value=False, pull=True)
periph_alarm = alarm.pin.PinAlarm(pins.PERIPH_EN, value=True, pull=True)
usb_alarm = alarm.pin.PinAlarm(board.CHARGE_STATUS, value=False, pull=False)
# wakeup = alarm.light_sleep_until_alarms(pin_alarm, usb_alarm)
# print(wakeup.pin)
time_alarm = alarm.time.TimeAlarm(monotonic_time=time.monotonic() + LIGHT_SLEEP_TIMEOUT)
print("sleeping")
wakeup = alarm.light_sleep_until_alarms(time_alarm, pin_alarm, usb_alarm)
