furbrain/STIC/firmware/installer/boot.py

# noinspection PyUnresolvedReferences
from firmware.utils import usb_power_connected

if usb_power_connected():
    # noinspection PyPackageRequirements
    import supervisor
    supervisor.runtime.autoreload = False
else:
    # noinspection PyPackageRequirements
    import storage
    storage.remount("/", False)
