furbrain/STIC/(commit log)

2023-01-15 start work on button and case
    [STIC.step, button_mould.FCStd, button_mould_large.FCStd, case.FCStd]
2023-01-18 Add PCB designs
    [Button.kicad_pcb, Button.sch, STIC.kicad_pcb, STIC.sch, STIC.step, button_mould_large.FCStd]
2023-01-19 More work on PCB and schematic
    Fat boy made and working!
    [STIC.kicad_pcb, STIC.sch]
2023-01-21 Start work on first proper case
    [bigboy.FCStd]
2023-01-22 Update button schematic and simplify directory structure
    [Button.kicad_pcb, Button.sch]
2023-01-22 Update main PCB design
    [Button.step, STIC.kicad_pcb, STIC.step]
2023-01-22 Update main design
    [bigboy.FCStd]
2023-01-22 Add display_mount
    [display_mount.FCStd]
2023-01-22 Add bigboy and update .gitignore
    [bigboy.FCStd]
2023-01-22 More work on case and button assemblies
    [Button.kicad_pcb, Button.step]
2023-01-23 Add millproject files
2023-01-27 Move PCB kicad dir up one
    [Button.kicad_pcb, STIC.kicad_pcb, STIC.sch, STIC.step]
2023-02-26 update hardware files, note Button and main board are not connected proper
    [Button.kicad_pcb, Button.step, STIC.kicad_pcb, STIC.sch]
2023-02-26 Various case fixes
    [button_mould_large.FCStd]
2023-03-01 Fix error in order of pins on button PCB, and other minor PCB fixes
    [Button.kicad_pcb, Button.sch, STIC.kicad_pcb, STIC.sch]
2023-03-01 Add cap to case
2023-03-01 Add stl files
    [bigboy-Shell.stl, bigboy-Shim.stl, bigboy-mount.stl, display_mount.stl]
2023-03-01 finish case models
    [Acrylic.dxf, EVA Foam.dxf, case.FCStd]
2023-03-17 Convert main pcb to work with egismos laser
    [STIC.kicad_pcb, STIC.sch]
2023-03-17 Update button board to have two non-illuminated buttons
    [Button.kicad_pcb, Button.sch]
2023-03-18 Update board to show new display, and minor tidying on button board
    [Button.kicad_pcb, Button.step, STIC.kicad_pcb, STIC.sch, STIC.step]
2023-03-19 start adjusting case for egismos laser
2023-04-10 Add inverting pwm code
    [invertingpwmio.py]
2023-05-09 Add battery charger IC and switch caps to SMT tech
    [STIC.kicad_pcb, STIC.sch, STIC.step]
2023-05-13 Various case updates
    [Button.step, STIC.step, bigboy-Shell.stl, bigboy-Shim.stl, bigboy-mount.stl, button_mould_large.FCStd]
2023-05-13 Update pcb to include battery charging and smaller current controller
    [STIC.csv, STIC.kicad_pcb, STIC.sch]
2023-05-13 Add BOM details to button
    [Button.csv, Button.kicad_pcb, Button.step]
2023-05-13 Bit more space for battery
    [bigboy-Shell.stl]
2023-05-13 Tidy up BOM
    [Button.csv, Button.sch]
2023-05-17 Major changes in firmware
    Main routine is to do light sleep (30 uA) for up to 6 hours, and then to
    switch to deep sleep (20uA). These are both fairly similar to self-discharge
    rates fro a 1000 mAh battery, so not too shabby
    There is a bug in the displayio code which loses about 16-32 bytes per startup
    - I think this is OK, should be fixed in future versions of CP
    Abstract most app-dependent code into app.py
    Start using memorymap instead of uctypes
    Abstract pin definitions to pins.py
    Use lazy loading for hardware.py
    [app.py, data.py, display.py, hardware.py, pins.py, utils.py]
2023-05-17 Fix minor bug in invertingpwm.py
    [invertingpwmio.py]
2023-05-20 Increase height for battery Remove accidental internal spur Add connection for button boots
2023-05-20 New button mould - simplified, doubled, and letters put on
    [button_mould.FCStd]
2023-05-20 Add laser bitmap
2023-05-20 Add Calibration routine
2023-05-20 Make device reset if usb status and storage mount statsu mismatch
    [app.py]
2023-05-20 Create charging animation
2023-05-24 More work on button mould
    [button_mould.FCStd, button_mould_large.FCStd]
2023-05-29 Case modifications
    [Acrylic.dxf, button_mould.FCStd]
2023-05-29 Make null calibration use correct axes
    [app.py]
2023-05-29 Make calibration more user friendly, but still work to do
2023-05-29 Correct default axes and timeout
    [config.py]
2023-05-29 Reset laser when turning off
    [hardware.py]
2023-05-29 Update charging animation and fix bugs
    [usb_mode.py]
2023-05-29 Include battery image
2023-05-30 Add more info to charging screen
2023-05-30 Bit more debugging and bug fixes
    [hardware.py]
2023-05-31 make laser work again
2023-05-31 rename laser image
2023-05-31 discarding queue work
    move test to tests dir
    rmeove print statement
2023-06-01 Get laser error screen working
    [app.py, display.py]
2023-06-11 Various startup and shutdown fixes
    [app.py, calibrate.py, display.py, hardware.py]
2023-06-11 Add anomaly checking
    Also switch to newer menu builder
2023-06-16 Add battery monitoring
2023-06-17 Various work on fixing current consumption
    [bluetooth.py, hardware.py]
2023-06-17 Limited code to test battery current consumption
2023-06-18 Add bezel
    [bigboy-Shell.stl, button_mould.FCStd]
2023-06-18 Make boot thickerer
    [button_mould.FCStd]
2023-06-19 Turn things off appropriately when files are changed when USB attached - prevents hangs
    [hardware.py]
2023-06-19 Make mould base a bit deeper, add flanges
    [button_mould.FCStd]
2023-06-30 make display flip when device turned over
    [app.py, config.py, display.py]
2023-06-30 make it fit the new battery and bezels
    [STIC.step, bigboy-mount.stl]
2023-07-05 Minor fixes and updates
    [display.py, info.py, menu.py, utils.py]
2023-07-05 Add laser distance calibration
2023-07-05 Further work on button mould
    [button_mould.FCStd]
2023-07-05 Fix bug in exception handling/shutdown
    [app.py, bitmaps.py, bluetooth.py]
2023-07-26 Switch to caveble instead of distox
2023-07-26 More work on safety when not calibrated
2023-08-03 Get calibration working in a nasty way
    Calibration uses loads of RAM. This change
    stores calibration shots in flash, then resets
    and runs calibration
    [app.py, calibrate.py, measure.py, menu.py, utils.py]
2023-08-31 Multiple style and minor bug fixes
    [button_mould.FCStd]
2023-09-01 Lots more typo etc corrections
    [app.py, bluetooth.py, boot.py, calibrate.py, config.py, data.py, debug.py]
2023-09-16 Move firmware into its own dir on device
2023-09-16 Fix bugs in calibration routine
    [calibrate.py]
2023-09-17 Get laser calibration working
2023-09-27 Make charging display not go crazy when fully charged
2023-09-27 Simple code to look at calibration data and shots data and do simple analysis on them
2023-09-27 Change so we control strictness and set tolerances, not mag_cal
    [config.py, measure.py, menu.py]
2023-09-27 Refactor measurement so calibration and measurement use same technique. Also allow saving a set of shots for debugging purposes
2023-09-27 Rest when leaving usb charging mode, so we don't have nasty delays restarting
2023-11-01 Bug fix in usb mode
    [usb_mode.py]
2023-11-01 Add voltage to raw data screen
2023-11-02 Refactor debug functions and implement battery test function
2023-11-02 Fix bugs due to laser functions needing to be async
    [hardware.py, measure.py]
2023-12-16 Add battery life info and construction info to manual
2023-12-16 Update to 3d models
    [Acrylic.dxf, bigboy-Shim.stl]
2023-12-16 Detect triple shots and signal with laser
2023-12-17 make docs pull current sw version
2024-01-03 implement naive timer
2024-01-07 Add more error correction to measurement code in case of timeout
    [measure.py]
2024-01-07 Increase magnetometer accuracy (adds 10ms to measurement time)
2024-01-07 implement basic timer config
2024-01-07 update docs to include mention of timer
2024-01-08 naively disable laser in menu
2024-01-13 Flip now a bit less sensitive
    [app.py]
2024-01-15 Replace time.monotonic with supervisor.ticks_ms()
    main.py:122 will not be affected by this bug for approximately 300 years.
    [app.py, main.py]
2024-01-19 Various PCB work
    Add laser and battery to schematic (but not board, obvs)
    Add second battery connector to allow JST-PH2 connectors
    Add helpful silkscreen to board
    [STIC.kicad_pcb, STIC.sch]
2024-01-19 Add farnell part number
    [STIC.sch]
2024-01-20 Automatically generate gerber files and a BOM
    * Convert to Kicad 7
    * make jumper on button PCB J0 to avoid clash
    * Generate PCB files on push
    * Install kicad7 on workflow
    * More work on the BOM
    [Button.kicad_pcb, Button.kicad_sch, STIC.kicad_sch, STIC.sch]
2024-01-21 Change timer -> shot timer
2024-01-21 Add assembly instructions
2024-01-21 Add pin 1 markers
2024-01-22 Compatibility change for CircuitPython 9.0
2024-02-11 show errors in calibration routine
    [app.py, calibrate.py, debug.py]
2024-02-24 Various fixes for memory usage bugs
    [app.py, calibrate.py, debug.py, display.py, installer.py, main.py, menu.py]
2024-02-24 Final fixes for bug on write and memory shortages
    Also removes some testing code and update device info screen
    [calibrate.py, display.py, info.py, menu.py]
2024-03-23 Add various footprints
2024-03-23 Update to Kicad v8.
    Make board 5mm shorter and add SMD components
    [STIC.kicad_sch]
2024-03-24 Revert "Add various footprints"
    This reverts commit 9badc14f357fbbb192e723c9a867f7c831b323fd.
2024-03-24 Revert "Update to Kicad v8."
    This reverts commit 377b650fb4ed8263ac52fe62880b4f170809fcf5.
    [STIC.kicad_sch]
2024-03-25 Make code easier to adapt to new hardware
    Squashed commit of the following:
    commit 9e273239895c395933fe92376976d3913918b7b0
    Author: Phil Underwood <beardydoc@gmail.com>
    Date: Mon Mar 25 22:23:14 2024 +0000
    Minor tidying
    commit 4b3d9e6ce90798ca84ad813508c9f15cfca63165
    Author: Phil Underwood <beardydoc@gmail.com>
    Date: Mon Mar 25 22:05:26 2024 +0000
    Minor fixes to installer
    commit e0d054afc629707e18096ff76b5c3097a1db26a4
    Author: Phil Underwood <beardydoc@gmail.com>
    Date: Mon Mar 25 21:59:33 2024 +0000
    Installer now sets hardware version and allows to skip main code installation
    commit 1a265fc2dd1c61780dfae278a937903ef4e2e3d4
    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
    [app.py, boot.py, calibrate.py, config.py, data.py, debug.py]
2024-03-27 Fix bugs in installer.py and menu.py
    [installer.py, menu.py]
2024-03-27 Remove bluetooth battery service as not used
    Saves 500 bytes
    Saves 1k
2024-03-29 Switch to cholesky algorithm
    This significantly reduces calibration memory usage, and allows to do calibration "live"
2024-03-29 Revert "Remove bluetooth battery service as not used"
    This reverts commit 84d170af707373c4a2f1b9177b9b914d41c253d5.
    [app.py, bluetooth.py]
2024-03-29 Improve memory utilisation, calibration can now be done "live"
    Remove unused bits of code
    Remove bluetooth battery service as not used
    Remove unused/duplicated code
    Switch to cholesky algorithm
    bits of tidying
    Revert "Remove bluetooth battery service as not used"
    bug fix
    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
    [app.py, calibrate.py, data.py, debug.py, discarding_queue.py, display128x64.py, installer.py, main.py]
2024-03-29 Merge from 6.2: Enables easy addition of other hardware setups
    # Conflicts:
    # firmware/calibrate.py
    # firmware/debug.py
    # firmware/installer/installer.py
    # firmware/pins.py
    # firmware/utils.py
    # firmware/version.py
    # firmware/versions/display128x64.py
2024-04-02 Bug fix for #23
    [display128x64.py, version.py]
2024-04-20 Add youtube link for calibration
2024-04-21 update button to kicad8
    [Button.kicad_pcb, Button.kicad_sch]
2024-05-04 Merge 6.2 into main
    Makes the case 5mm shorter
    Also sets up "layout" system for various hardware
    # firmware/docs/source/conf.py
    # firmware/layouts.py
    # firmware/requirements.txt
    # hardware/Button/Button.kicad_pro
    # hardware/PCB/STIC.kicad_pcb
    # hardware/PCB/STIC.kicad_prl
    # hardware/PCB/STIC.kicad_pro
    # hardware/PCB/STIC.kicad_sch
    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
    [STIC.kicad_sch, STIC.step, bigboy-mount.stl]
2024-05-05 Make laser flashes more responsive
2024-05-05 Bump version
    This version makes the device a little more responsive and includes a framework to have different PCB layouts and hardware configurations
2024-05-05 Update to use kicad v8
2024-06-15 Add display testing code - for a separate single time board
2024-06-17 Correct part number for C1,C2
    [STIC.kicad_sch]
2024-08-21 Update pcb
2024-10-05 update schematic so laser cable included in BOM
    [STIC.kicad_sch]
2024-11-10 Tidy raw and calibrated displays
2024-11-10 Bluetooth boost (#32)
    * Boost bluetooth power on nrf52840
    * Start advertising again when connection lost
2024-11-10 Implement Florian Ballenegger's algorithm for correcting sensor roll - improved accuracy (#33)
    [calibrate.py, calibrate_roll.py]
2024-11-16 Add button jig
    [button_pcb_jig.stl]
2025-05-25 bug fix for calibration with roll
    [calibrate_roll.py]
2025-05-25 bug fix for menu persistence bug
    [menu.py]
2025-05-25 fix bug where does not display on bluetooth
    [bluetooth.py]
2025-06-13 hardware fixes
    [bigboy-mount.stl]
2026-01-03 Version 1.5.0 does crash on my device (SAP6_IA) quite frequently. This happens particularly predictably when alternating correct measurements with errors (magnetic, laser). Debugging revealed that mo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
    [display128x64.py, measure.py]
2026-01-05 recognize only legs with all three shots near each other. (#38)
    Thanks for this @spic17 - merged
2026-03-13 add circuitpython firmware
2026-05-23 send acoustic signal for magnetic error. (#40)
    [hardware.py, measure.py]
2026-05-23 Bump version, fix error from merge
    [measure.py, version.py]
